1801BM1/remul/readme.md

## International preface
This project contains materials regarding the ancient Soviet chips
of 1801 series. This line presents the package of ULA designs, based
on the same logical matrix chip. The 1801 chips were mass produced
in the 80th of XX century in the USSR and were used mostly within
Soviet PDP-11 clones related products, and were not very popular
or even known at all outside the iron curtain. Nowadays these chips
are interesting for retrocomputing community on the post-Soviet areas
as for former users of Soviet PDP-11 computers. This community mostly
speaks in Russian as native language, so the articles and documents
in this project are written in Russian. If some notable international
interest is found the translations to English may happen. All working
materials (schematics, topologies, HDL sources) are in English.
Please, feel free to contact me with questions and comments.

## Предисловие
РЕ-мулятор представляет собой печатную плату в габаритах корпуса DIP-24 и
предназначен для непосредственной замены микросхем типа 1801РЕ2 и 1801РР1
в различных устройствах.

С использованием дополнительных внешних входов выбора кристалла РЕ-мулятор
способен заменить до 32 отдельных независимых микросхем типа 1801РЕ2/РР1.
Например, возможна одновременная замена одним эмулятором шести микросхем
1801РЕ2 на основной плате БК-0010 плюс плата модуля МСТД/Фокал. Для БК-0011М
один РЕ-мулятор способен заменить до семи микросхем (на основной плате
и дополнительно на плате Бейсика)

РЕ-мулятор построен на основе недорогого и распространенного микроконтроллера
STM32F205, работающего на частоте 120МГц. Допускается замена программного
обеспечения микроконтроллера без отключения РЕ-мулятора от платы для которой
осуществляется эмуляция. Таким образом можно быстро изменять "прошивку"
эмулируемой микросхемы без вынимания РЕ-мулятора из панельки, что очень
удобно при разработке программ для ROM.

Поле конфигурации, реализованное на перемычках ("джамперах") позволяет
управлять режимом работы РЕ-мулятора без частой замены прошивки
микроконтроллера.

По мере разработки и усовершенствования программного обеспечения функционал
РЕ-мулятора может быть значительно расширен, выходя за рамки простой эмуляции
ПЗУ. Например, возможно использование одного из дополнительных выводов
для генерации сигнала DOUT, РЕ-мулятор сможет осуществлять циклы записи
на шине МПИ и выполнять самостоятельное тестирование устройства,
без участия центрального процессора схемы (разумеется, сам ЦП следует
отключить сигналами захвата шины).

Программирование микроконтроллера может осуществляться с использованием
полного JTAG, "укороченного" SWJ или по последовательному интерфейсу
UART (с иcпользованием внешнего преобразователя уровней RS-232 и предварительно
запрограммированного загрузчика). Программирование по UART и SWJ допускается
без отключения РЕ-мулятора от схемы. При использовании JTAG без отключения
от схемы следует обеспечить размыкание цепей проходящих через R4 и R5.
Для программирования по  JTAG/SWJ можно использовать стандартные
программаторы/отладчики типа JLink, ST-Link, MT-Link. 

## Как это выглядит
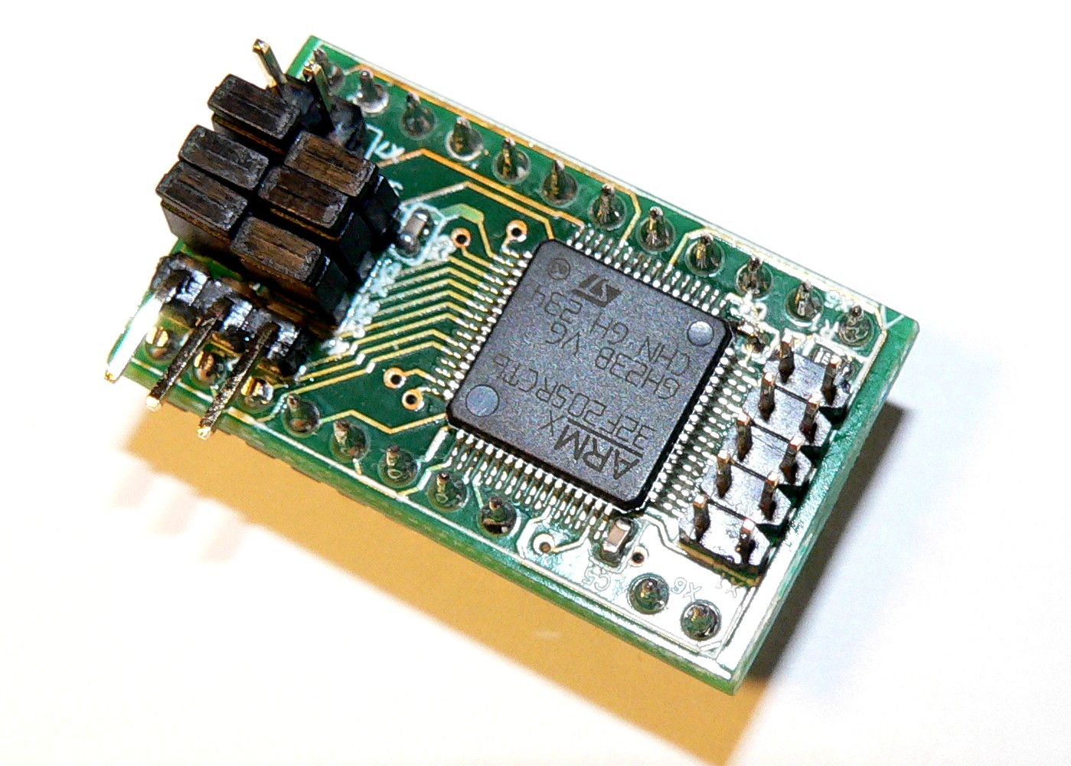
[picture p1: img/p1.jpg]
p1


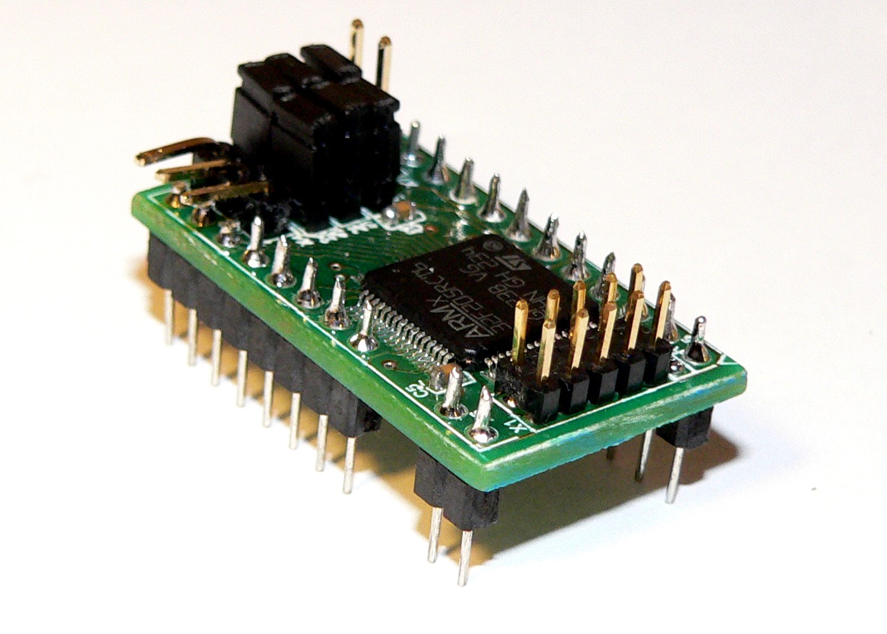
[picture p2: img/p2.jpg]
p2


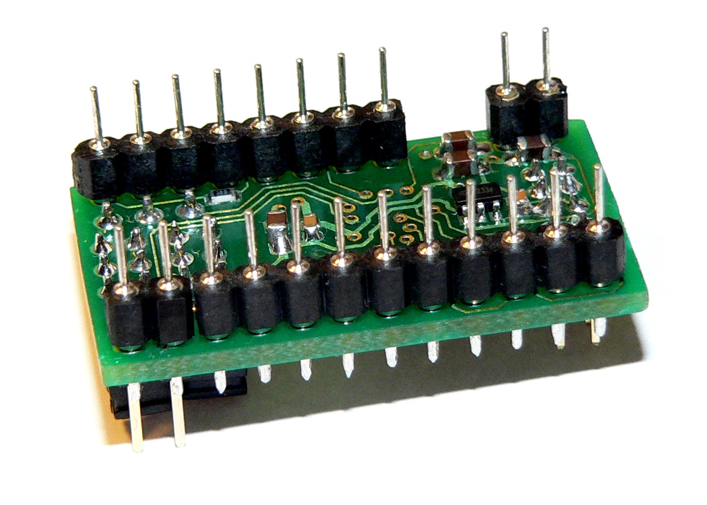
[picture p3: img/p3.jpg]
p3


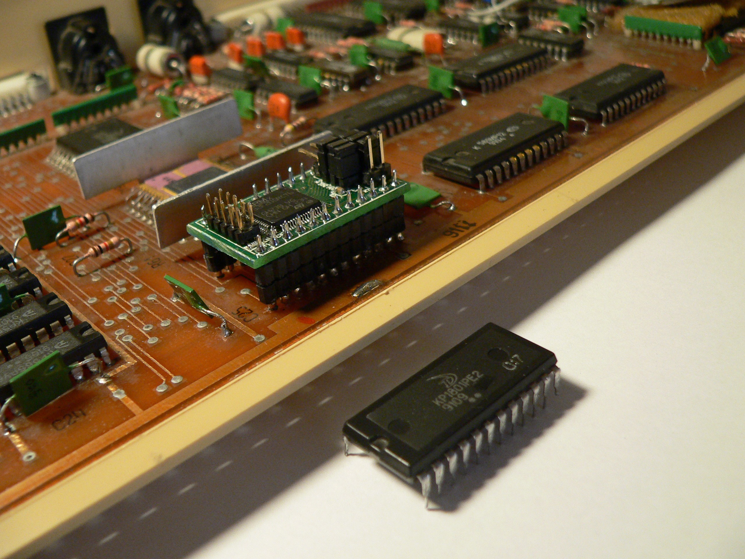
[picture p4: img/p4.jpg]
p4


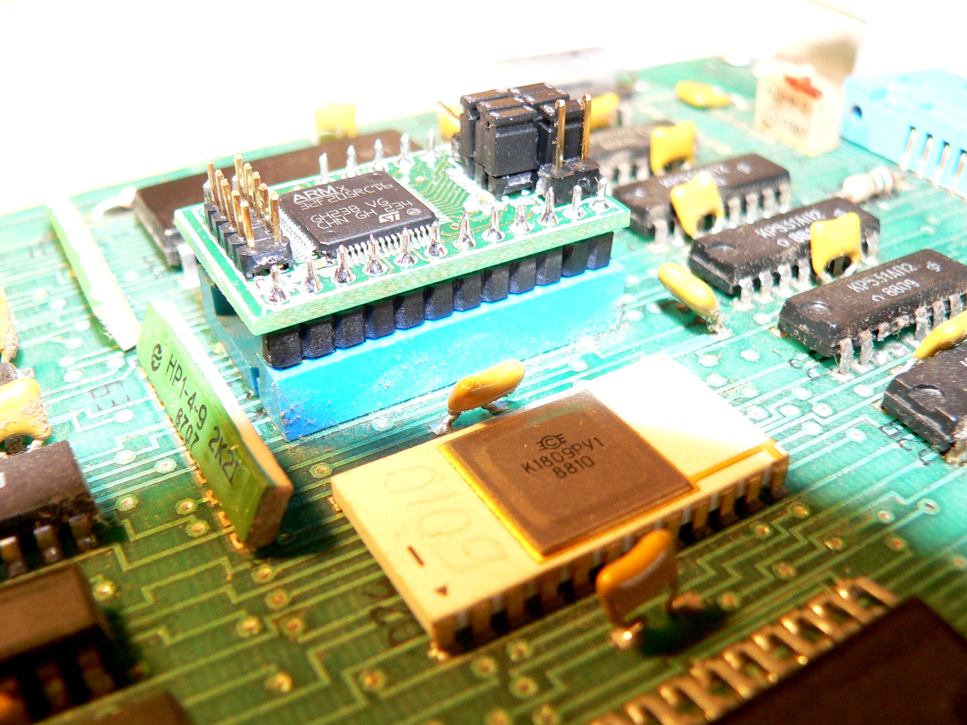
[picture p5: img/p5.jpg]
p5
