1801BM1/remul/hex/readme.txt

Уже построенные сборки для конфигураций БК

a205_gcc.hex   - файл управляющего кода, компиляция GCC
a205_gcc10.hex - файл управляющего кода, компиляция GCC плюс данные эмуляции для конфигураций БК-0010
a205_gcc11.hex - файл управляющего кода, компиляция GCC плюс данные эмуляции для конфигураций БК-0011М
a205_iar.hex   - файл управляющего кода, компиляция IAR
a205_iar10.hex - файл управляющего кода, компиляция IAR плюс данные эмуляции для конфигураций БК-0010
a205_iar11.hex - файл управляющего кода, компиляция IAR плюс данные эмуляции для конфигураций БК-0011M
bk0010.hex     - данные эмуляции для конфигураций БК-0010
bk0011m.hex    - данные эмуляции для конфигураций БК-0011M
