1801BM1/remul/doc/1801pp1_component.rtf

DD1 | Ìèêðîêîíòðîëëåð ñåðèè STM32F20x, êîðïóñ LQFP-64. Ìîæåò áûòü ïðèìåíåí ëþáîé èç êîíòðîëëåðîâ: • STM32F205RB • STM32F205RC (ïðåäïî÷òèòåëåí) • STM32F205RE • STM32F205RF • STM32F205RG • STM32F215RE • STM32F215RG Áîëüøèíñòâî ïðîãðàììíîãî îáåñïå÷åíèÿ áóäåò ôóíêöèîíèðîâàòü íà âñåõ ïåðå÷èñëåííûõ êîíòðîëëåðàõ, íî åñòü âåðîÿòíîñòü ÷òî íåêîòîðûå âåðñèè ïîòðåáóþò áîëåå 64 êèëîáàéò îïåðàòèâíîé ïàìÿòè è áîëåå 128Ê ôëåøà, ïîýòîìó ðåêîìåíäîâàíî ïðèìåíåíèå ìèêðîêîíòðîëëåðà STM32F205RC è áîëåå ñòàðøèõ.
DD2 | OnSemi NCP551SN33, ëèíåéíûé ñòàáèëèçàòîð íàïðÿæåíèÿ, ñ ôèêñèðîâàííûì âûõîäîì 3,3Â, òîêîì äî 100ìÀ, â êîðïóñå SOT23-5.
VT1 | Òðàíçèñòîð BC817
R1 | 22 êÎì, òèïîðàçìåð 0603
R2 | 220 Îì, òèïîðàçìåð 0603
R3 | 22 êÎì, òèïîðàçìåð 0603
R4 | 0 Îì, òèïîðàçìåð 0603 (èë ïðîñòî ïåðåìû÷êà)
R5 | 0 Îì, òèïîðàçìåð 0603 (èë ïðîñòî ïåðåìû÷êà)
C1 | 1 íÔ, 10Â, òèïîðàçìåð 0603
C2 | 0.1 ìêÔ, 10Â, òèïîðàçìåð 0603
C3 | 2.2 ìêÔ, 10Â, òèïîðàçìåð 0805
C4 | 0.1 ìêÔ, 10Â, òèïîðàçìåð 0603, ðåêîìåíäîâàíà çàìåíà íà 0402 è ìîíòàæ ñî ñìåùåíèåì (êîðïóñ ìèêðîêîíòðîëëåðà ìåøàåò íîðìàëüíîé óñòàíîâêå)
C5 | 0.1 ìêÔ, 10Â, òèïîðàçìåð 0603
C6 | 2.2 ìêÔ, 10Â, òèïîðàçìåð 0805
C7 | 0.1 ìêÔ, 10Â, òèïîðàçìåð 0603
C8 | 4.7 ìêÔ, 10Â, òèïîðàçìåð 0805
C9 | 4.7 ìêÔ, 10Â, òèïîðàçìåð 0805
SA1-SA6 | PLS2 (ïî êàòàëîãó «Áóðûé ìåäâåäü»), øòûðè îäíîðÿäíûå ñ øàãîì 2 ìì, íà íèõ íàäåâàþòñÿ ïåðåìû÷êè (äæàìïåðû), îáðàçóÿ 6-áèòíîå ïîëå êîíôèãóðàöèè. Ïðè íåîáõîäèìîñòè øòûðè ìîæíî íå óñòàíàâëèâàòü, ôèêñèðîâàííóþ êîíôèãóðàöèþ çàäàòü ïðè ïîìîùèé ïàéêè ìîíòàæíûõ ïåðåìû÷åê.
X1 | PLD2 (ïî êàòàëîãó «Áóðûé ìåäâåäü»), øòûðè äâóõðÿäíûå ñ øàãîì 2 ìì, ðàçúåì ñëóæèò äëÿ ïðîãðàììèðîâàíèÿ ìèêðîêîíòðîëëåðà ïî ïîñëåäîâàòåëüíîìó èíòåðôåéñó è JTAG
X2-X4 | PLS (ïî êàòàëîãó «Áóðûé ìåäâåäü»), øòûðè îäíîðÿäíûå. Äîïîëíèòåëüíûå âõîäû, ìîãóò íå óñòàíàâëèâàòüñÿ åñëè íå ïðåäïîëàãàåòñÿ îäíîâðåìåííàÿ ýìóëÿöèÿ íåñêîëüêèõ ìèêðîñõåì
X5-X6 | PLSM – øòûðè öàíãîâûå, èëè äðóãèå ïîäõîäÿùèå, îäíîðÿäíûå, ñ øàãîì 2.54ìì
X7 | WH2 èëè PLD2 – ðàçúåì âûõîäà ãîòîâíîñòè/ñáðîñà âíåøíåãî ïðîöåññîðà/ïëàòû
