1801BM1/remul/doc/1801pp1_assembly.pdf

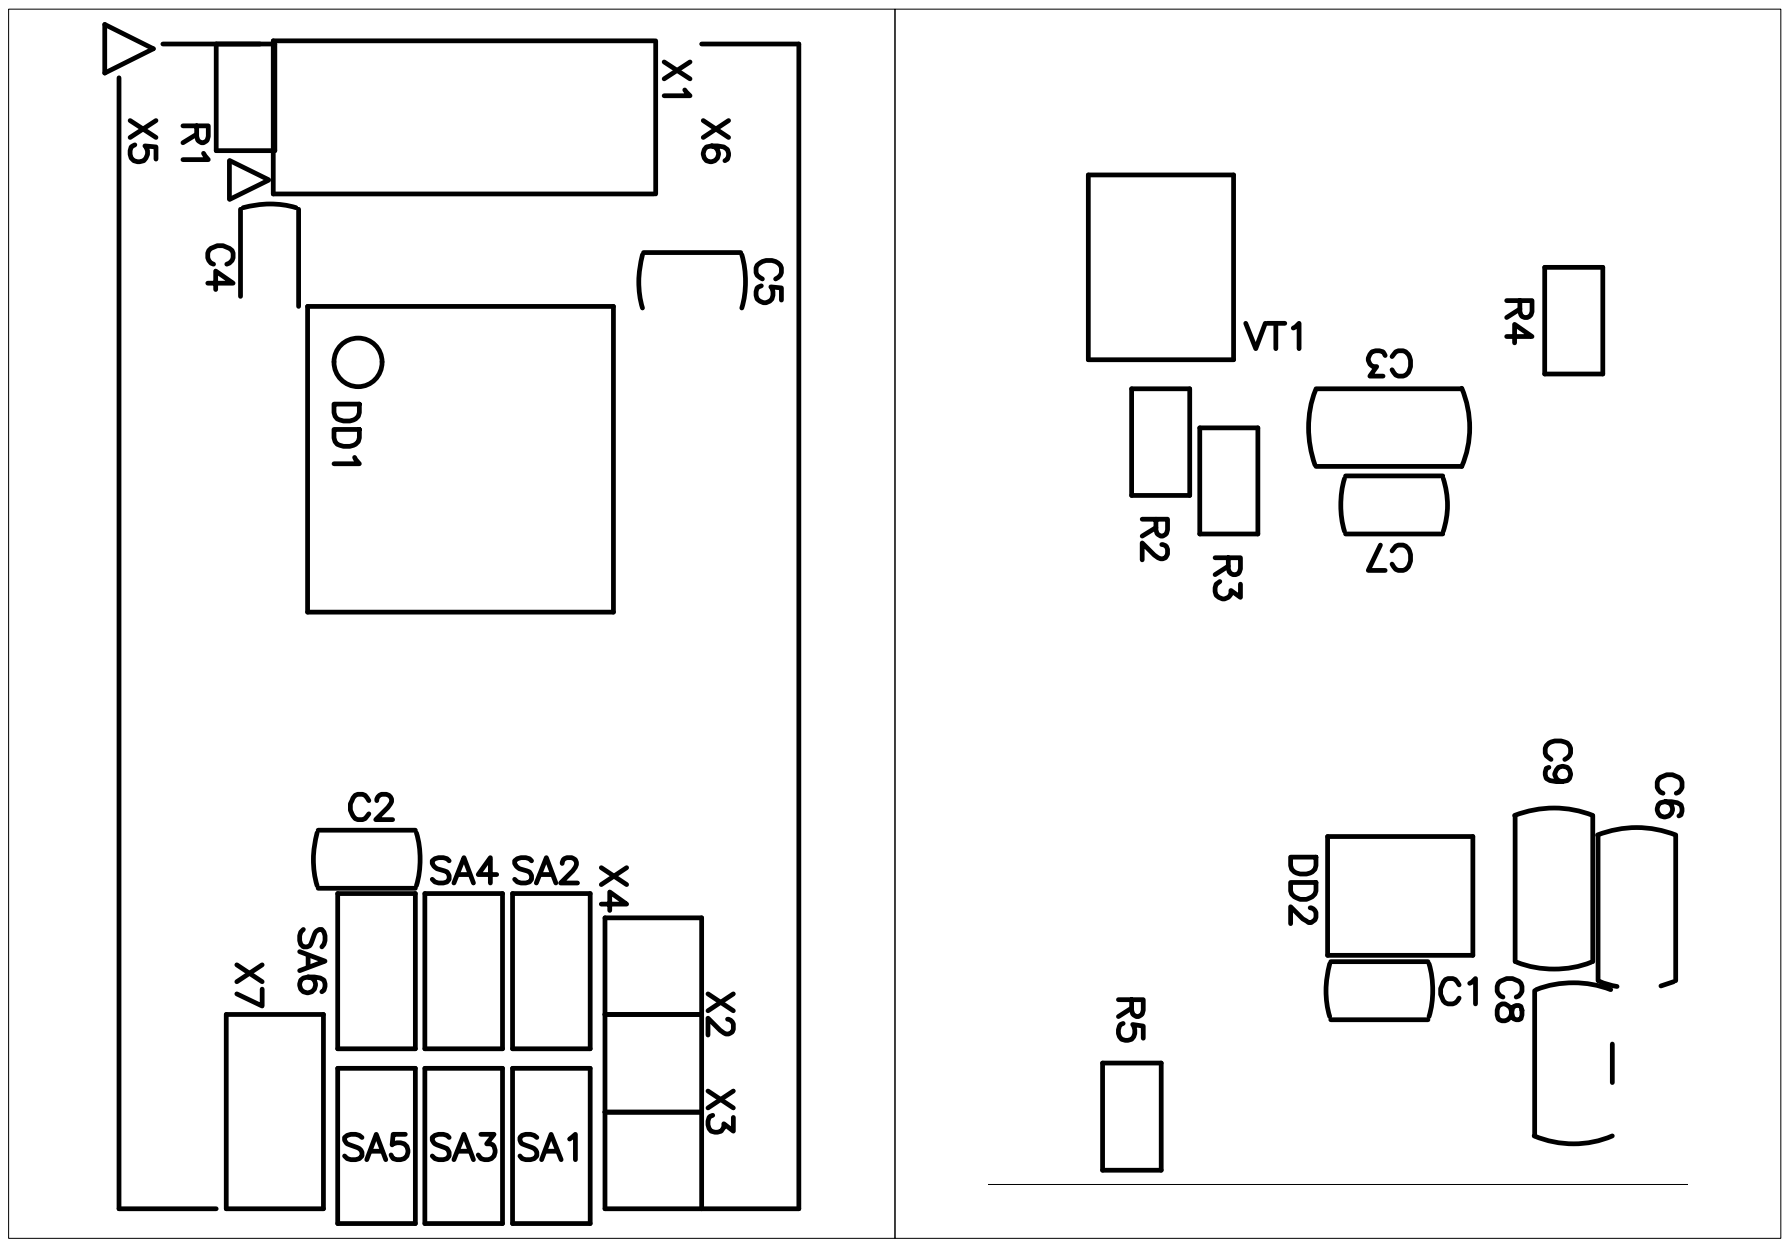
[picture p6: page 1]
