1801BM1/remul/doc/1801pp1_schematic.pdf

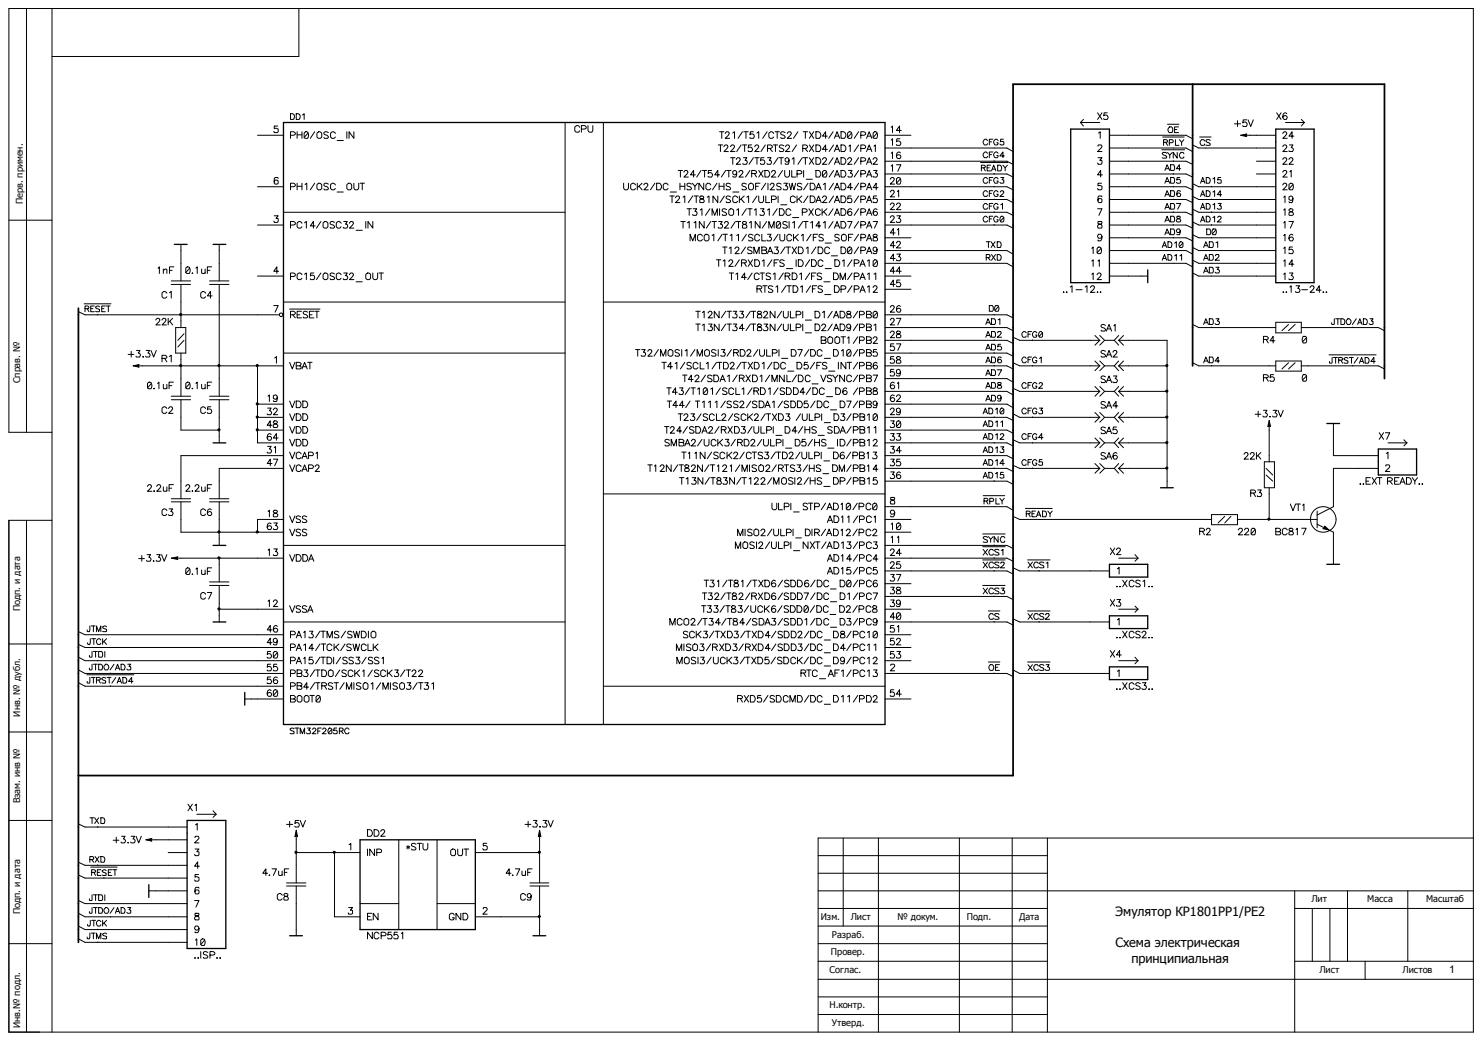
[picture p7: page 1]

Инв.№ подл. Взам. инв № Инв. № дубл. Подп. и дата Подп. и дата Перв. примен. Справ. №

Э м ул я тор КР1801PP 1/PE2 Сх ема э л е кт р и ч еская п рин ципи а л ь ная | Лит | М асса | М а с ш таб

Изм . | Л ист | № докум . | П одп . | Д ата
Р азраб .
П р овер .
С оглас . | | | | | Л ист | Л и с тов 1

Н .контр .
Утверд .
