1801BM1/remul/(list of files, drawings)

Other design files:
cad/1801pp1_mini.pcb
